Equerm8/stm32-clone/datasheets/stlink pinout.png

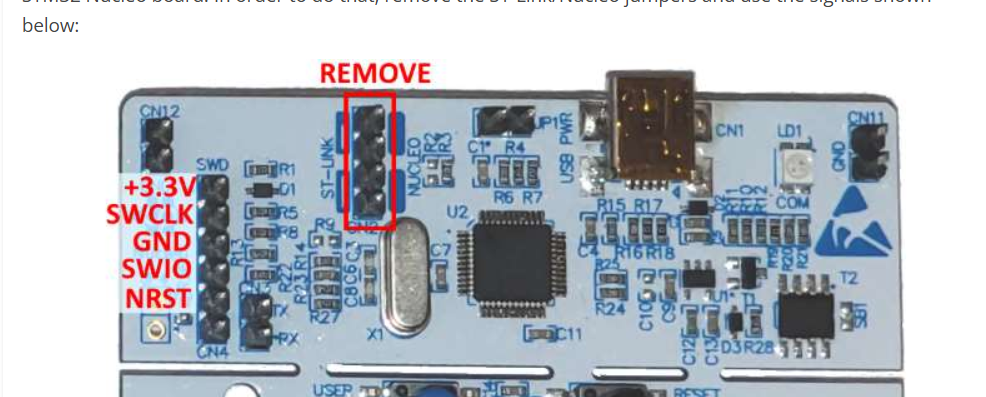
datasheets/stlink pinout.png
