Equerm8/stm32-clone/stm32 clone/components.csv

Cart | Reference | Qty | Value | Footprint | Datasheet | URL
FA£SZ | C1,C3,C19 | 3 | 100nF | Capacitor_SMD:C_0805_2012Metric_Pad1.18x1.45mm_HandSolder
FA£SZ | C2 | 1 | 4.7uF | Capacitor_SMD:C_0805_2012Metric_Pad1.18x1.45mm_HandSolder
FA£SZ | C4 C5 | 2 | 22pF | Capacitor_SMD:C_0805_2012Metric_Pad1.18x1.45mm_HandSolder
FA£SZ | C6, C7 | 2 | 18pF | Capacitor_SMD:C_0805_2012Metric_Pad1.18x1.45mm_HandSolder
FA£SZ | C8 | 1 | 0.1uF | Capacitor_SMD:C_0805_2012Metric_Pad1.18x1.45mm_HandSolder
FA£SZ | C9, C11, C12 | 3 | 10uF | Capacitor_SMD:C_0805_2012Metric_Pad1.18x1.45mm_HandSolder
FA£SZ | C13 | 1 | 10nF | Capacitor_SMD:C_0805_2012Metric_Pad1.18x1.45mm_HandSolder
FA£SZ | D1 | 1 | 1N5819 | Diode_THT:D_DO-15_P12.70mm_Horizontal | https://www.tme.eu/Document/7e78c56f041fe00f7158152d6ddb2c6e/1n5817.pdf | https://www.tme.eu/pl/details/1n5819-dio/diody-schottky-tht/diotec-semiconductor/1n5819/
FA£SZ | D2 | 1 | 1N5908 | Diode_THT:D_DO-201AE_P15.24mm_Horizontal | https://www.tme.eu/Document/b573c1072669355e40bbb17bb3e94432/1N5908.pdf | https://www.tme.eu/pl/details/1n5908/diody-tvs-tht-jednokierunkowe/stmicroelectronics/
FA£SZ | D3 | 1 | LED_PWR | LED_THT:LED_D5.0mm
FA£SZ | D4 | 1 | LED | LED_THT:LED_D5.0mm
FA£SZ | J1 | 1 | DEBUG | Connector_PinHeader_2.54mm:PinHeader_1x05_P2.54mm_Vertical
FA£SZ | J2 | 1 | USB_C_Receptacle_USB2.0_16P | Connector_USB:USB_C_Receptacle_GCT_USB4105-xx-A_16P_TopMnt_Horizontal | https://www.usb.org/sites/default/files/documents/usb_type-c.zip
FA£SZ | J3 | 1 | PA-PC-PB-Conn | Connector_PinHeader_2.54mm:PinHeader_1x10_P2.54mm_Vertical
FA£SZ | J5 | 1 | PB-PD-Conn | Connector_PinHeader_2.54mm:PinHeader_1x12_P2.54mm_Vertical
FA£SZ | J6 | 1 | PA-Conn | Connector_PinHeader_2.54mm:PinHeader_1x02_P2.54mm_Vertical
FA£SZ | J7 | 1 | PA-PB-Conn | Connector_PinHeader_2.54mm:PinHeader_1x11_P2.54mm_Vertical
FA£SZ | R1,R2 | 2 | 5k1 | Resistor_SMD:R_0805_2012Metric_Pad1.20x1.40mm_HandSolder
FA£SZ | R3,R4,R5 | 3 | 1k | Resistor_SMD:R_0805_2012Metric_Pad1.20x1.40mm_HandSolder
FA£SZ | R6 | 1 | 10k | Resistor_SMD:R_0805_2012Metric_Pad1.20x1.40mm_HandSolder
FA£SZ | SW1 | 1 | RST | Button_Switch_THT:SW_PUSH_6mm_2pin
FA£SZ | SW2 | 1 | USR_BTN | Button_Switch_THT:SW_PUSH_6mm_2pin
FA£SZ | U1 | 1 | STM32G030C6T6 | Package_QFP:LQFP-48_7x7mm_P0.5mm | https://www.st.com/resource/en/datasheet/stm32g030c6.pdf | https://www.tme.eu/pl/details/stm32g030c6t6/mikrokontrolery-st/stmicroelectronics/
FA£SZ | U2 | 1 | TPS1117LV33S | Package_TO_SOT_SMD:SOT-223-3_TabPin2 | https://www.tme.eu/Document/4bc160b374101d59d8b6409d0be1e024/TPS1117LVxxS.pdf | TPS1117LV33S
FA£SZ | Y1 | 1 | 8 MHz | Crystal:Crystal_HC49-4H_Vertical | https://botland.com.pl/index.php?controller=attachment&id_attachment=465 | https://botland.com.pl/rezonatory/167-rezonator-kwarcowy-8mhz-hc49-niski-10szt-5904422355418.html
FA£SZ | Y2 | 1 | 32.768 KHz | Crystal:Crystal_C38-LF_D3.0mm_L8.0mm_Vertical | https://www.piekarz.pl/pdf/1911/ | https://www.piekarz.pl/09670-rezonator-kwarcowy-32-768khz-fi-3x8mm/
