Equerm8/stm32-clone/casing/clone assembly.step

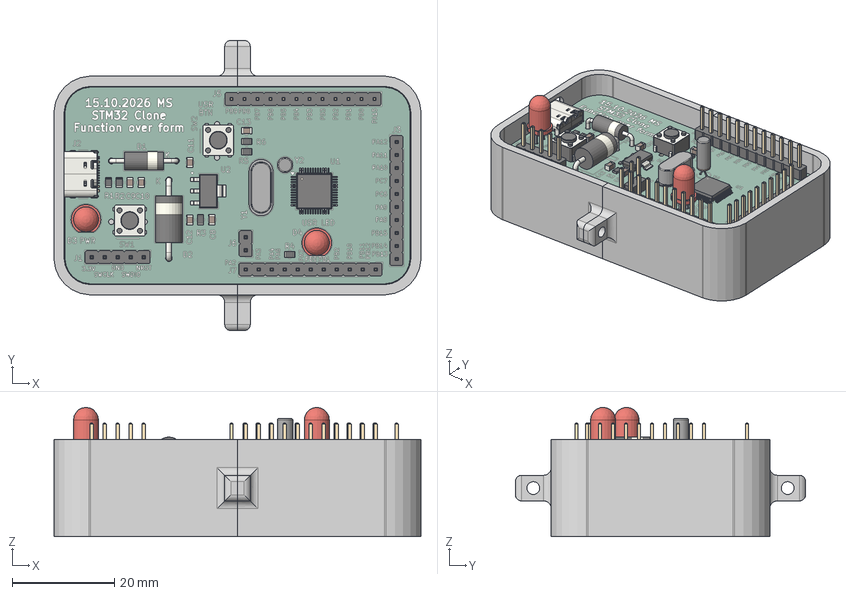
[picture p2: CAD file, 2026-10-17]
casing/clone assembly.step
71.7 x 56.7 x 25.2 mm
