Equerm8/stm32-clone/edge cuts.dxf

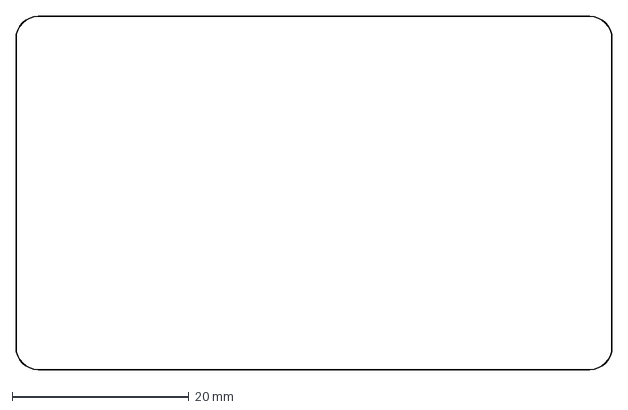
[picture p3: CAD file, 2026-10-15]
edge cuts.dxf
67.5 x 40.0 mm
