Equerm8/stm32-clone/casing/stm32 clone.step

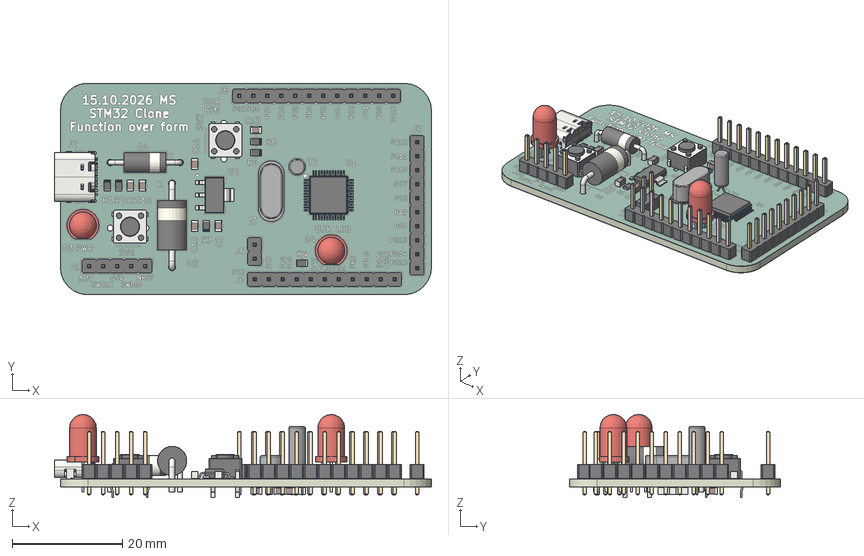
[picture p4: CAD file, 2026-10-17]
casing/stm32 clone.step
68.5 x 38.4 x 15.1 mm
SW_PUSH_6mm x 2
PinHeader_1x10_P254mm_Vertical
USB_C_Receptacle_16P_TopMnt_Horizontal_GCT_USB4105-xx-A
R_0805_2012Metric x 6
LED_D5.0mm x 2
C_0805_2012Metric x 13
D_DO-15_P12.70mm_Horizontal
PinHeader_1x11_P254mm_Vertical
SOT-223
D_DO-201AE_P15.24mm_Horizontal
Crystal_HC49-4H_Vertical
LQFP-48_7x7mm_P0.5mm
PinHeader_1x02_P254mm_Vertical
PinHeader_1x12_P254mm_Vertical
C38_LF_Vertical
PinHeader_1x05_P254mm_Vertical
stm195B_silkscreen x 2
stm195B_soldermask x 2
stm195B_PCB
