Equerm8/stm32-clone/stm32 clone/stm32 clone.kicad_pcb

## KiCad design stm32 clone/stm32 clone.kicad_pcb (2026-11-12)

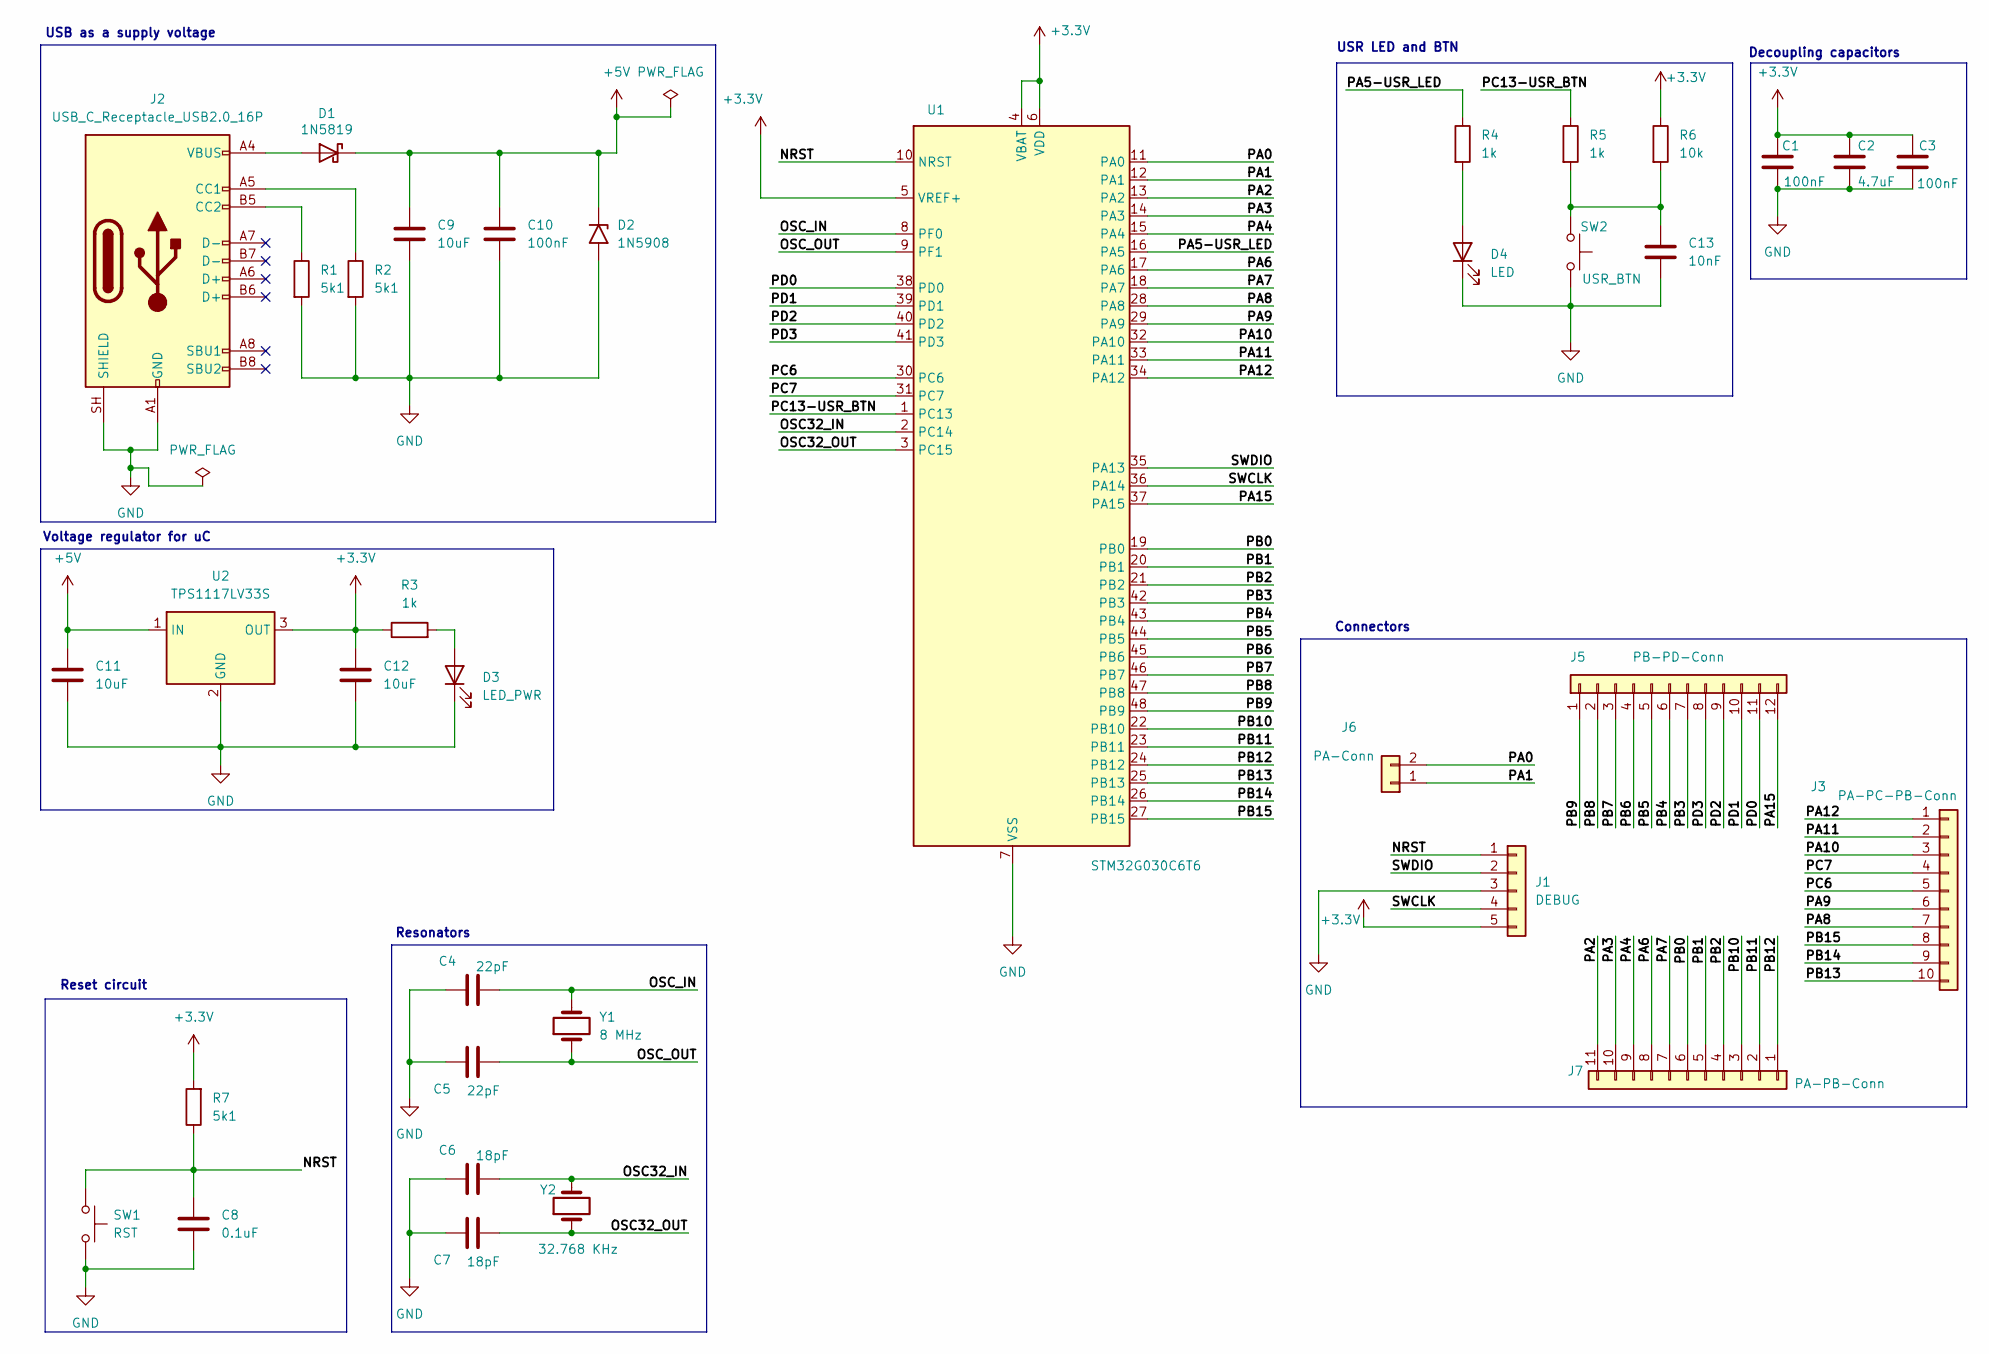
[picture p5: schematic stm32 clone.kicad_sch]

Parts:
C1, C3, C10: 100nF; C_0805_2012Metric_Pad1.18x1.45mm_HandSolder
C2: 4.7uF; C_0805_2012Metric_Pad1.18x1.45mm_HandSolder
C4, C5: 22pF; C_0805_2012Metric_Pad1.18x1.45mm_HandSolder
C6, C7: 18pF; C_0805_2012Metric_Pad1.18x1.45mm_HandSolder
C8: 0.1uF; C_0805_2012Metric_Pad1.18x1.45mm_HandSolder
C9, C11, C12: 10uF; C_0805_2012Metric_Pad1.18x1.45mm_HandSolder
C13: 10nF; C_0805_2012Metric_Pad1.18x1.45mm_HandSolder
D1: 1N5819; D_DO-15_P12.70mm_Horizontal
D2: 1N5908; D_DO-201AE_P15.24mm_Horizontal
D3: LED_PWR; LED_D5.0mm
D4: LED; LED_D5.0mm
J1: DEBUG; PinHeader_1x05_P2.54mm_Vertical
J2: USB_C_Receptacle_USB2.0_16P; USB_C_Receptacle_GCT_USB4105-xx-A_16P_TopMnt_Horizontal
J3: PA-PC-PB-Conn; PinHeader_1x10_P2.54mm_Vertical
J5: PB-PD-Conn; PinHeader_1x12_P2.54mm_Vertical
J6: PA-Conn; PinHeader_1x02_P2.54mm_Vertical
J7: PA-PB-Conn; PinHeader_1x11_P2.54mm_Vertical
R1, R2, R7: 5k1; R_0805_2012Metric_Pad1.20x1.40mm_HandSolder
R3, R4, R5: 1k; R_0805_2012Metric_Pad1.20x1.40mm_HandSolder
R6: 10k; R_0805_2012Metric_Pad1.20x1.40mm_HandSolder
SW1: RST; SW_PUSH_6mm_2pin
SW2: USR_BTN; SW_PUSH_6mm_2pin
U1: STM32G030C6T6; LQFP-48_7x7mm_P0.5mm
U2: TPS1117LV33S; SOT-223-3_TabPin2
Y1: 8 MHz; Crystal_HC49-4H_Vertical
Y2: 32.768 KHz; Crystal_C38-LF_D3.0mm_L8.0mm_Vertical

Connections:
+3.3V: C1.1, C2.1, C3.1, C12.1, J1.5, R3.1, R6.1, R7.2, U1.4 (VBAT), U1.5 (VREF+), U1.6 (VDD), U2.3 (OUT)
+5V: C9.1, C10.1, C11.1, D1.1 (K), D2.1 (A1), U2.1 (IN)
/NRST: C8.1, J1.1, R7.1, SW1.1, U1.10 (NRST)
/OSC32_IN: C6.2, U1.2 (PC14), Y2.2
/OSC32_OUT: C7.2, U1.3 (PC15), Y2.1
/OSC_IN: C4.2, U1.8 (PF0), Y1.2
/OSC_OUT: C5.2, U1.9 (PF1), Y1.1
/PA0: J6.2, U1.11 (PA0)
/PA1: J6.1, U1.12 (PA1)
/PA2: J7.11, U1.13 (PA2)
/PA3: J7.10, U1.14 (PA3)
/PA4: J7.9, U1.15 (PA4)
/PA5-USR_LED: R4.1, U1.16 (PA5)
/PA6: J7.8, U1.17 (PA6)
/PA7: J7.7, U1.18 (PA7)
/PA8: J3.7, U1.28 (PA8)
/PA9: J3.6, U1.29 (PA9)
/PA10: J3.3, U1.32 (PA10)
/PA11: J3.2, U1.33 (PA11)
/PA12: J3.1, U1.34 (PA12)
/PA15: J5.12, U1.37 (PA15)
/PB0: J7.6, U1.19 (PB0)
/PB1: J7.5, U1.20 (PB1)
/PB2: J7.4, U1.21 (PB2)
/PB3: J5.7, U1.42 (PB3)
/PB4: J5.6, U1.43 (PB4)
/PB5: J5.5, U1.44 (PB5)
/PB6: J5.4, U1.45 (PB6)
/PB7: J5.3, U1.46 (PB7)
/PB8: J5.2, U1.47 (PB8)
/PB9: J5.1, U1.48 (PB9)
/PB10: J7.3, U1.22 (PB10)
/PB11: J7.2, U1.23 (PB11)
/PB12: J7.1, U1.24 (PB12)
/PB13: J3.10, U1.25 (PB13)
/PB14: J3.9, U1.26 (PB14)
/PB15: J3.8, U1.27 (PB15)
/PC6: J3.5, U1.30 (PC6)
/PC7: J3.4, U1.31 (PC7)
/PC13-USR_BTN: R5.1, U1.1 (PC13)
/PD0: J5.11, U1.38 (PD0)
/PD1: J5.10, U1.39 (PD1)
/PD2: J5.9, U1.40 (PD2)
/PD3: J5.8, U1.41 (PD3)
/SWCLK: J1.4, U1.36 (PA14)
/SWDIO: J1.2, U1.35 (PA13)
GND: C1.2, C2.2, C3.2, C4.1, C5.1, C6.1, C7.1, C8.2, C9.2, C10.2, C11.2, C12.2, C13.2, D2.2 (A2), D3.1 (K), D4.1 (K), J1.3, J2.A1 (GND), J2.A12 (GND), J2.B1 (GND), J2.B12 (GND), J2.SH (SHIELD), R1.2, R2.2, SW1.2, SW2.2, U1.7 (VSS), U2.2 (GND)
unnamed: C13.1, R5.2, R6.2, SW2.1
unnamed: D1.2 (A), J2.A4 (VBUS), J2.A9 (VBUS), J2.B4 (VBUS), J2.B9 (VBUS)
unnamed: D3.2 (A), R3.2
unnamed: D4.2 (A), R4.2
unnamed: J2.A5 (CC1), R2.1
unnamed: J2.B5 (CC2), R1.1

Notes on the sheet:
USR LED and BTN
Decoupling capacitors
Reset circuit
USB as a supply voltage
Resonators
Voltage regulator for uC
Connectors

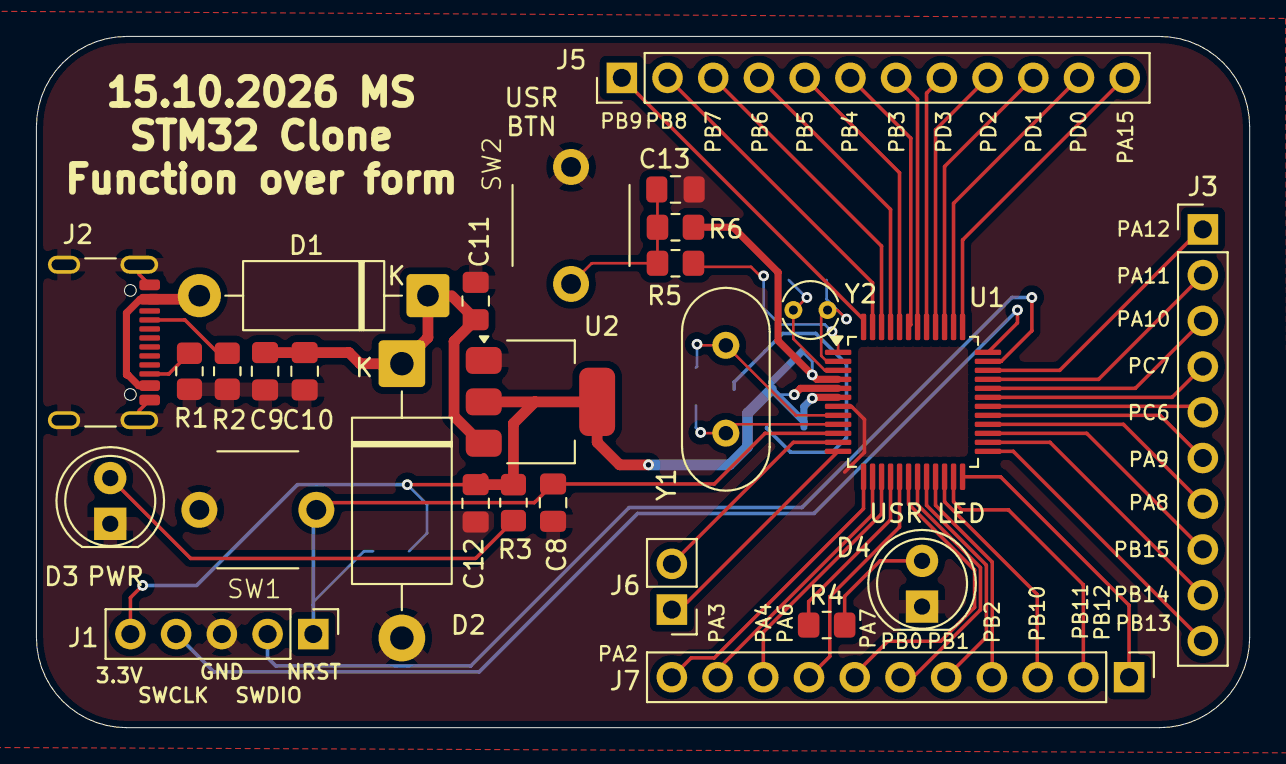
[picture p6: board stm32 clone.kicad_pcb from above]

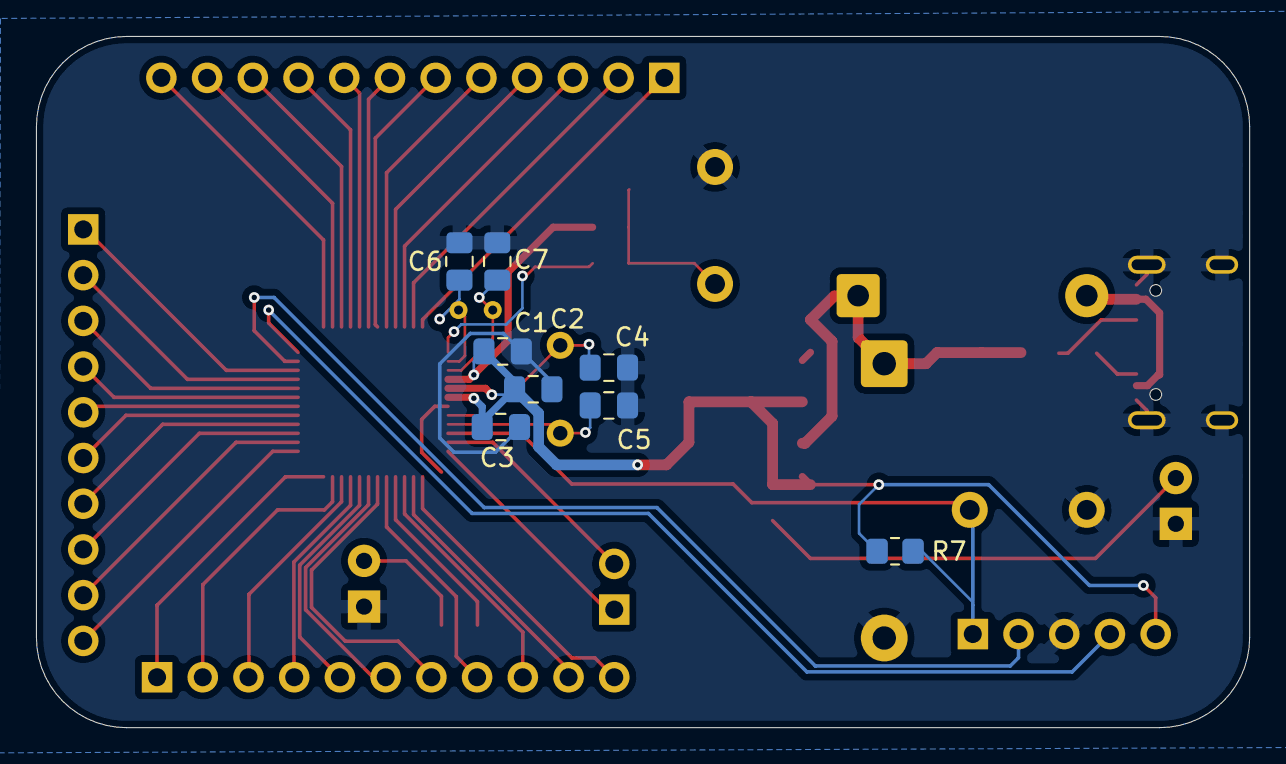
[picture p7: board stm32 clone.kicad_pcb from below]

Board: 4 copper layers, 67.4 x 38.4 mm, 36 parts (8 on the bottom side), 53 nets.
