Equerm8/stm32-clone/casing/clone assembly.png

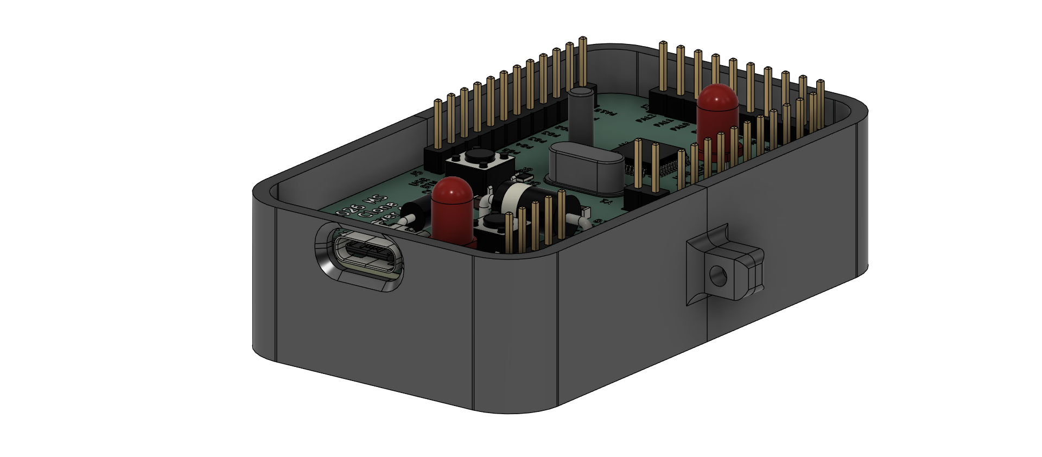
casing/clone assembly.png
