Equerm8/stm32-clone/stm32 clone/problems in polish.png

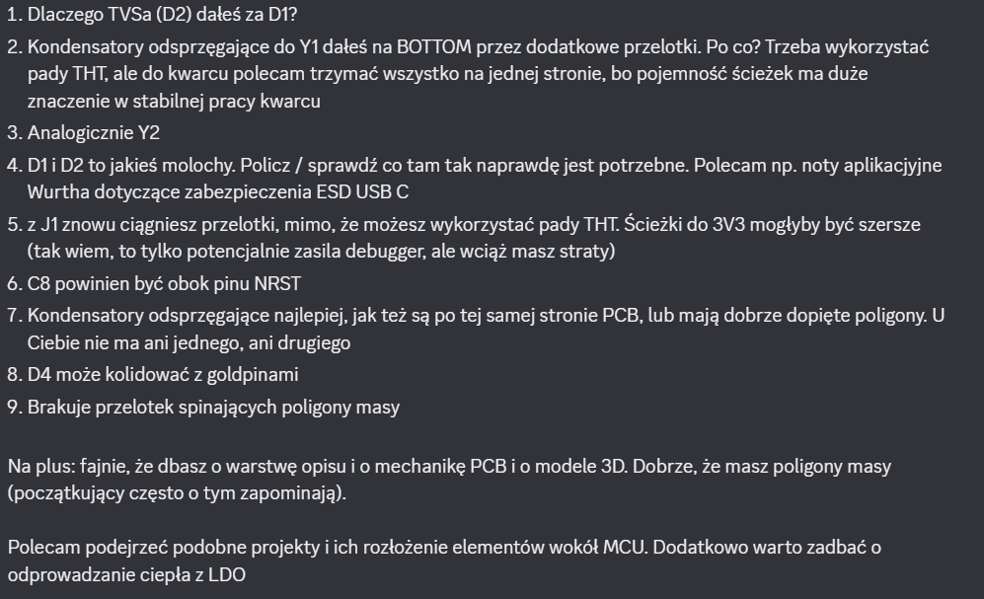
stm32 clone/problems in polish.png
