Equerm8/stm32-clone/stm32 clone/problems.png

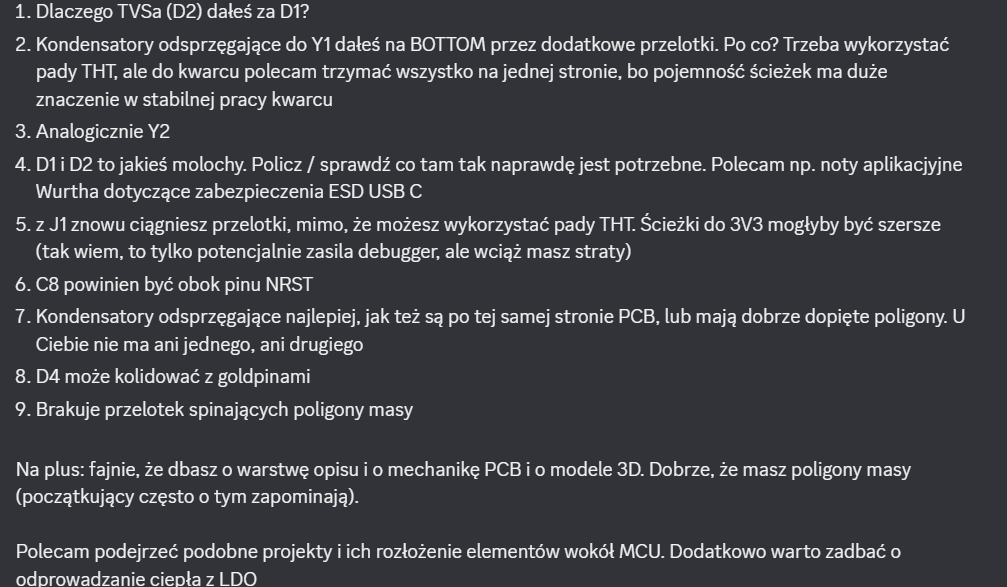
stm32 clone/problems.png
