Equerm8/stm32-clone/blink/blink.ioc

Mcu.UserName=STM32G030C6Tx
PA5.GPIO_Label=USR_LED
PA5.Signal=GPIO_Output
