Equerm8/stm32-clone/(commit log)

2026-10-11 crystal, decoupling caps, pcb generated
    [stm32 clone.kicad_pcb, stm32 clone.kicad_sch]
2026-10-11 reset circuit, debug
    [stm32 clone.kicad_sch]
2026-10-11 cubeide config
    [stm32 clone.kicad_sch]
2026-10-12 move object
    [stm32 clone.kicad_sch]
2026-10-12 usb c started
    [stm32 clone.kicad_sch]
2026-10-12 comments, usb c
    [stm32 clone.kicad_sch]
2026-10-12 usb finished
    [stm32 clone.kicad_sch]
2026-10-12 some changes in connectors
    nothing special
    [stm32 clone.kicad_sch]
2026-10-14 schematic main part done
    [stm32 clone.kicad_sch]
2026-10-14 pcb init and bill
    [components.csv, stm32 clone.kicad_pcb, stm32 clone.kicad_sch]
2026-10-14 component placement, main routes
    [stm32 clone.kicad_pcb]
2026-10-15 connections, edge cuts
    [stm32 clone.kicad_pcb]
2026-10-15 gnd, connections, drc rules
    [edge cuts.dxf, stm32 clone.kicad_pcb]
2026-10-15 fin i think
    [stm32 clone.kicad_pcb]
2026-10-17 casing complete
    [clone assembly.step, stm32 clone.step]
2026-11-12 blink added
    [stm32 clone.kicad_sch]
2026-11-12 additional resistor and ldo repair pads
    [stm32 clone.kicad_pcb, stm32 clone.kicad_sch]
2026-11-12 pcb repair
    [stm32 clone.kicad_pcb]
